BrnoMarsRover/astro_bio/pcb/AstroBio_v1/ad.kicad_pcb

## KiCad design pcb/AstroBio_v1/ad.kicad_pcb (2026-09-03)

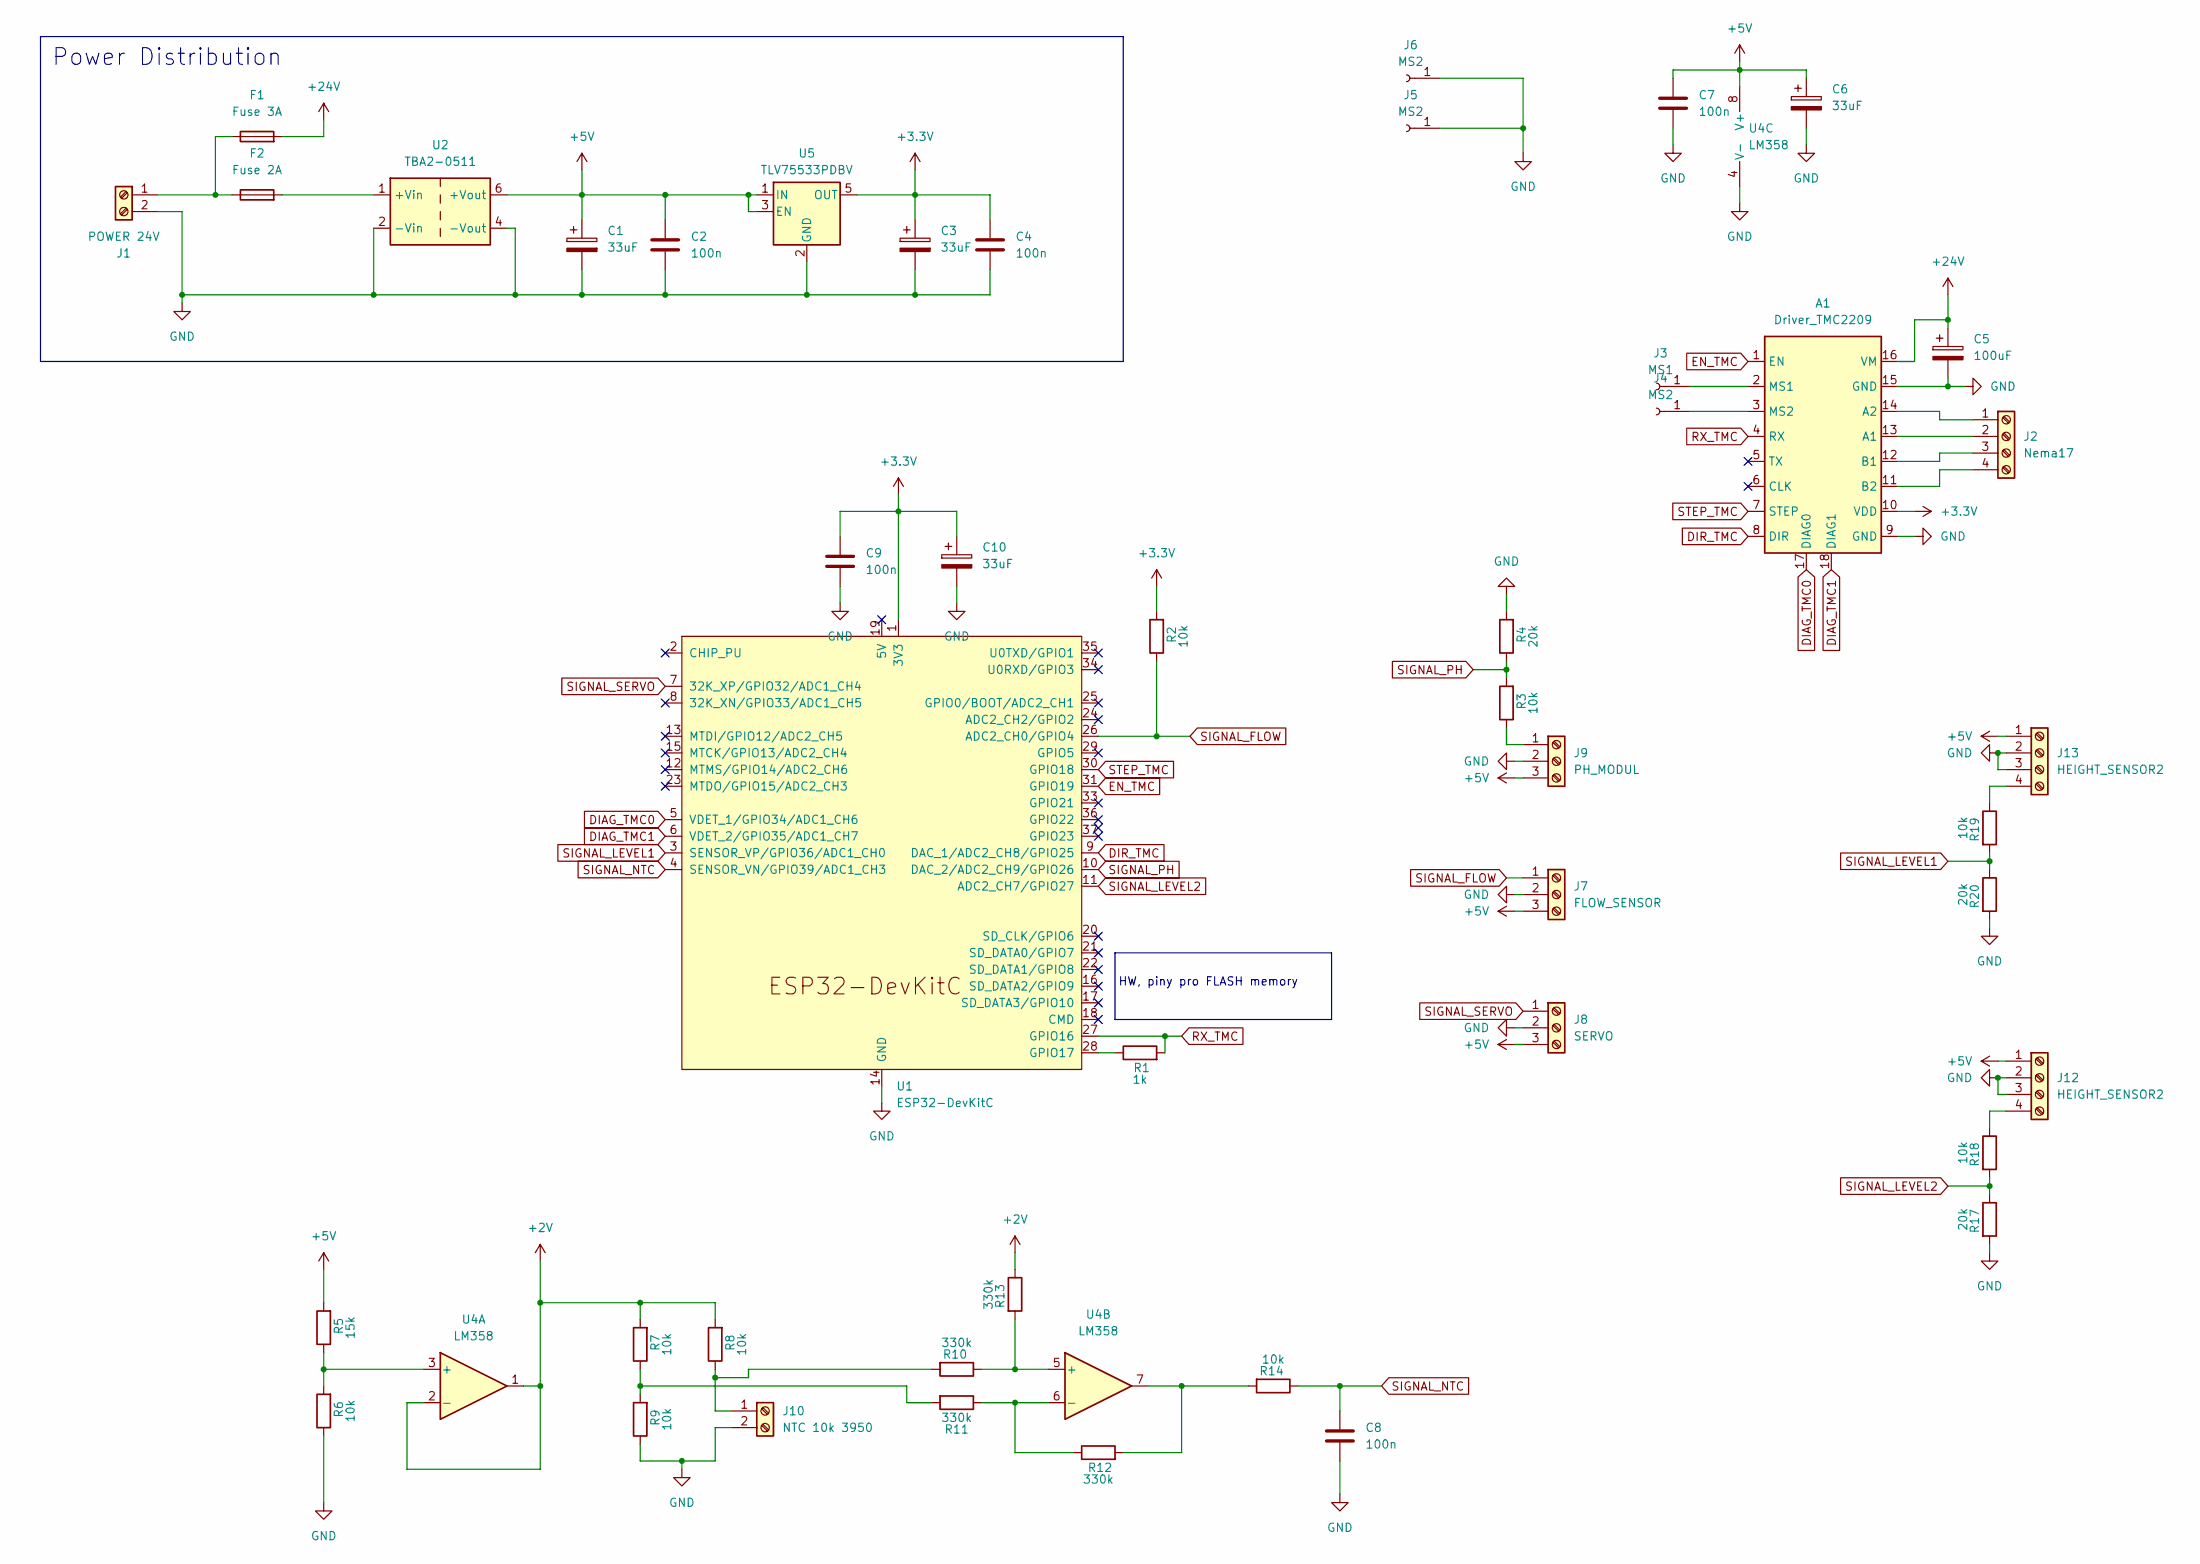
[picture p1: schematic ad.kicad_sch]

Parts:
A1: Driver_TMC2209; Pololu_Breakout-16_15.2x20.3mm
C1, C3: 33uF; CP_Radial_D8.0mm_P3.50mm
C2, C4, C7, C8, C9: 100n; C_1206_3216Metric_Pad1.33x1.80mm_HandSolder
C5: 100uF; CP_Radial_D8.0mm_P3.50mm
C6, C10: 33uF; CP_Radial_D5.0mm_P2.00mm
F1: Fuse 3A; fuseHolderATO
F2: Fuse 2A; fuseHolderATO
J1: POWER 24V; DEANS
J2: Nema17; JST_XH_B4B-XH-A_1x04_P2.50mm_Vertical
J3: MS1; Pin_D1.0mm_L10.0mm
J4, J5, J6: MS2; Pin_D1.0mm_L10.0mm
J7: FLOW_SENSOR; JST_XH_B3B-XH-A_1x03_P2.50mm_Vertical
J8: SERVO; JST_XH_B3B-XH-A_1x03_P2.50mm_Vertical
J9: PH_MODUL; JST_XH_B3B-XH-A_1x03_P2.50mm_Vertical
J10: NTC 10k 3950; JST_XH_B2B-XH-A_1x02_P2.50mm_Vertical
J12, J13: HEIGHT_SENSOR2; JST_XH_B4B-XH-A_1x04_P2.50mm_Vertical
R1: 1k; R_1206_3216Metric
R2, R3, R6, R7, R8, R9, R14, R18, R19: 10k; R_1206_3216Metric
R4, R17, R20: 20k; R_1206_3216Metric
R5: 15k; R_1206_3216Metric
R10, R11, R12, R13: 330k; R_1206_3216Metric
U1: ESP32-DevKitC
U2: TBA2-0511; dcdc_menic
U4: LM358; DIP-8_W7.62mm
U5: TLV75533PDBV; SOT-23-5

Connections:
+2V: R7.2, R8.2, R13.1, U4.1, U4.2 (-)
+3.3V: A1.10 (VDD), C3.1, C4.1, C9.1, C10.1, R2.2, U1.1 (3V3), U5.5 (OUT)
+5V: C1.1, C2.1, C6.1, C7.1, J7.3, J8.3, J9.3, J12.1, J13.1, R5.2, U2.6 (+Vout), U4.8 (V+), U5.1 (IN), U5.3 (EN)
+24V: A1.16 (VM), C5.1, F1.2
DIAG_TMC0: A1.17 (DIAG0), U1.5 (VDET_1/GPIO34/ADC1_CH6)
DIAG_TMC1: A1.18 (DIAG1), U1.6 (VDET_2/GPIO35/ADC1_CH7)
DIR_TMC: A1.8 (DIR), U1.9 (DAC_1/ADC2_CH8/GPIO25)
EN_TMC: A1.1 (EN), U1.31 (GPIO19)
GND: A1.9 (GND), A1.15 (GND), C1.2, C2.2, C3.2, C4.2, C5.2, C6.2, C7.2, C8.2, C9.2, C10.2, J1.2, J5.1 (Pin_1_1), J6.1 (Pin_1_1), J7.2, J8.2, J9.2, J10.2, J12.2, J12.3, J13.2, J13.3, R4.2, R6.1, R9.1, R17.2, R20.2, U1.14 (GND), U1.32 (GND), U1.38 (GND), U2.2 (-Vin), U2.4 (-Vout), U4.4 (V-), U5.2 (GND)
unnamed: A1.13 (A1), J2.2
unnamed: A1.14 (A2), J2.1
unnamed: A1.12 (B1), J2.3
unnamed: A1.11 (B2), J2.4
unnamed: A1.2 (MS1), J3.1 (Pin_1_1)
unnamed: A1.3 (MS2), J4.1 (Pin_1_1)
unnamed: F1.1, F2.1, J1.1
unnamed: J9.1, R3.1
unnamed: J10.1, R8.1, R10.2
unnamed: J12.4, R18.1
unnamed: J13.4, R19.1
unnamed: R7.1, R9.2, R11.2
unnamed: R12.2, R14.2, U4.7
unnamed: R1.1, U1.28 (GPIO17)
unnamed: F2.2, U2.1 (+Vin)
unnamed: R5.1, R6.2, U4.3 (+)
unnamed: R10.1, R13.2, U4.5 (+)
unnamed: R11.1, R12.1, U4.6 (-)
RX_TMC: A1.4 (RX), R1.2, U1.27 (GPIO16)
SIGNAL_FLOW: J7.1, R2.1, U1.26 (ADC2_CH0/GPIO4)
SIGNAL_LEVEL1: R19.2, R20.1, U1.3 (SENSOR_VP/GPIO36/ADC1_CH0)
SIGNAL_LEVEL2: R17.1, R18.2, U1.11 (ADC2_CH7/GPIO27)
SIGNAL_NTC: C8.1, R14.1, U1.4 (SENSOR_VN/GPIO39/ADC1_CH3)
SIGNAL_PH: R3.2, R4.1, U1.10 (DAC_2/ADC2_CH9/GPIO26)
SIGNAL_SERVO: J8.1, U1.7 (32K_XP/GPIO32/ADC1_CH4)
STEP_TMC: A1.7 (STEP), U1.30 (GPIO18)

Notes on the sheet:
HW, piny pro FLASH memory
Power Distribution

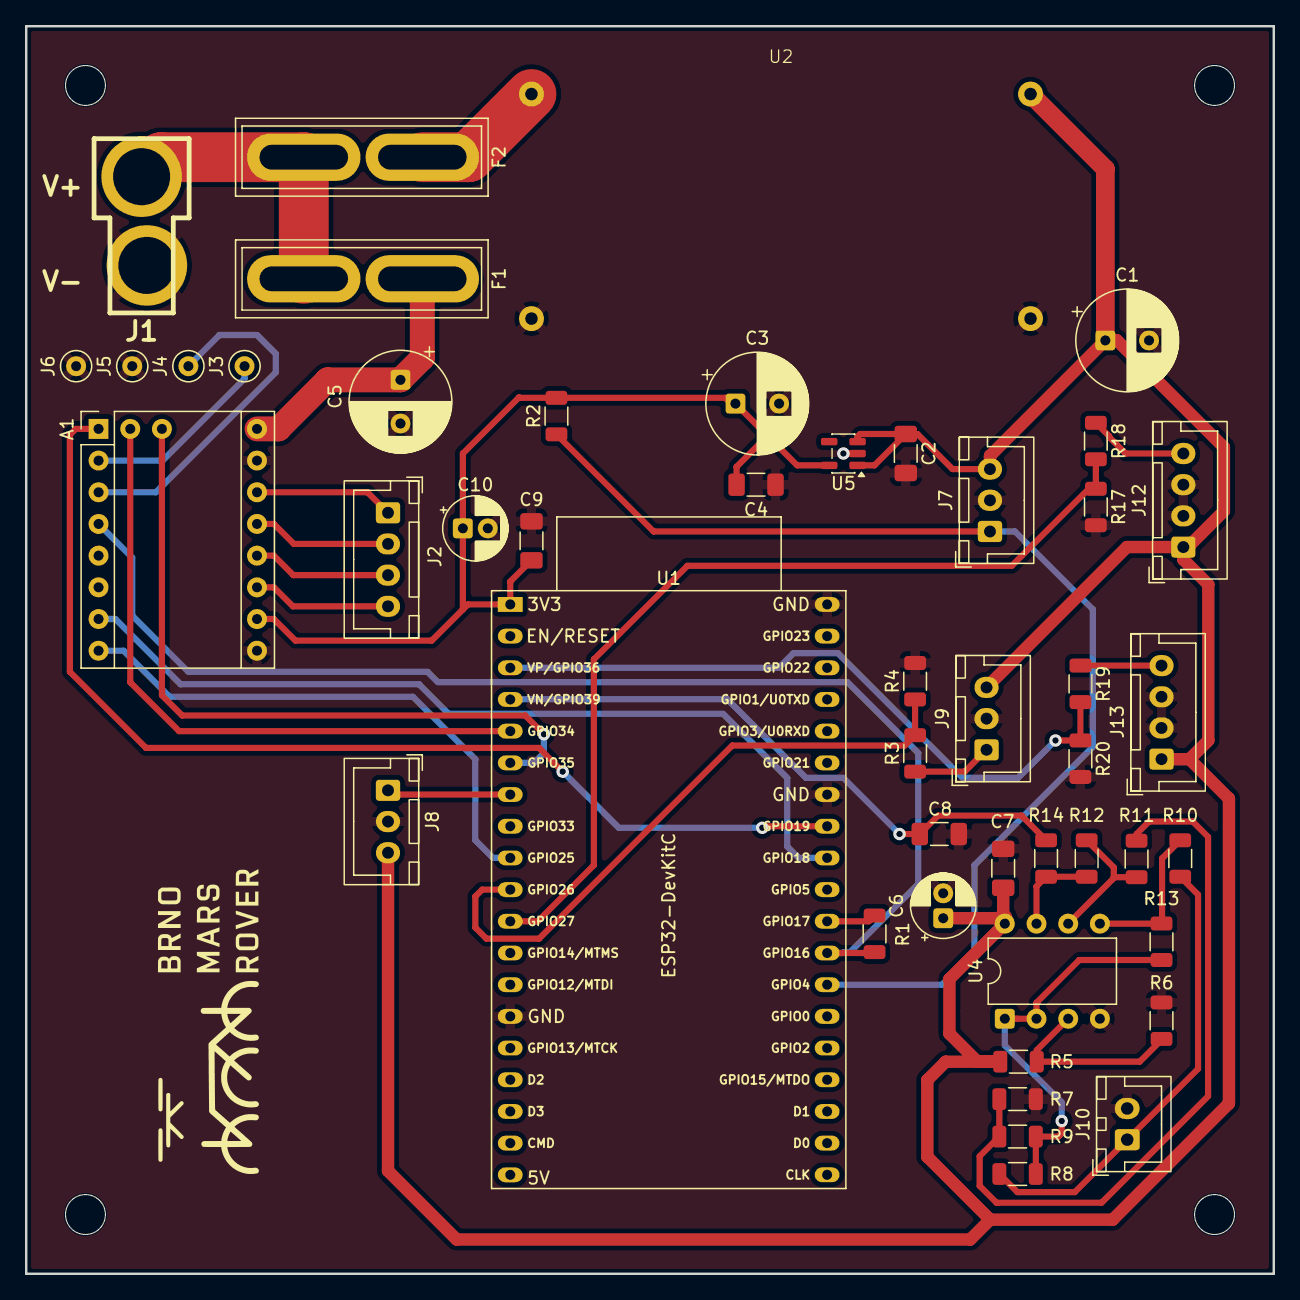
[picture p2: board ad.kicad_pcb from above]

Board: 2 copper layers, 100.0 x 100.0 mm, 47 parts (0 on the bottom side), 35 nets.
