BrnoMarsRover/astro_bio/(commit log)

2026-06-23 Added v1 of pcb
    [ad.kicad_pcb, ad.kicad_sch]
2026-06-26 Flip the ESP32 around and generate gerbers
    [ad-B_Cu.gbr, ad-B_Mask.gbr, ad-B_Paste.gbr, ad-B_Silkscreen.gbr, ad-Edge_Cuts.gbr, ad-F_Cu.gbr, ad-F_Mask.gbr, ad-F_Paste.gbr]
2026-06-26 change the LDO for a smaller one
    [ad-B_Cu.gbr, ad-B_Mask.gbr, ad-B_Paste.gbr, ad-B_Silkscreen.gbr, ad-Edge_Cuts.gbr, ad-F_Cu.gbr, ad-F_Mask.gbr, ad-F_Paste.gbr]
2026-08-28 Add an `id` command so the board can be identified over USB
    The three Freya ESP32 boards -- science, drilling and astro-bio -- are all
    ESP32-DevKitC behind a Silicon Labs CP2102, and their USB descriptors are
    identical: same 10c4:ea60, same factory serial "0001", same product string.
    cp210x-cfg cannot write the EEPROM, so this cannot be fixed on the hardware.
    They also collide in /dev/serial/by-id, where all three claim the same
    filename -- so with two attached, that link resolves to an arbitrary board
    while looking perfectly unambiguous.
    A host therefore cannot tell from the port which board it has opened. Until
    now the only stable name pointing here was /dev/asgard/drill_uart, a udev
    rule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
    [config.hpp, main.cpp]
